zimirken/Carbon-Arc-Lamp/image.png

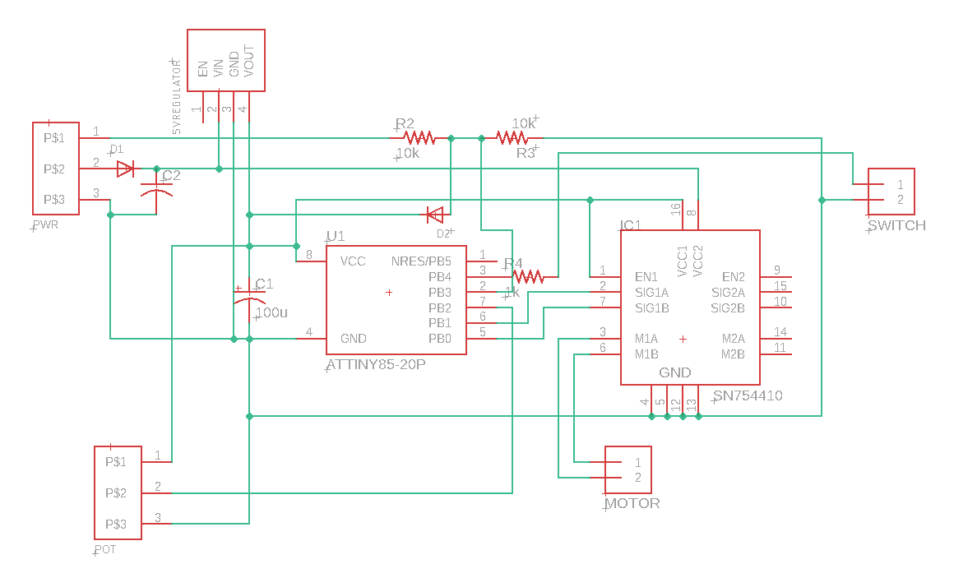
image.png
